antmicro/caravel_board/hardware/caravel_Nucleo/caravel_Nucleo.kicad_pcb

## KiCad design hardware/caravel_Nucleo/caravel_Nucleo.kicad_pcb (2022-12-19)

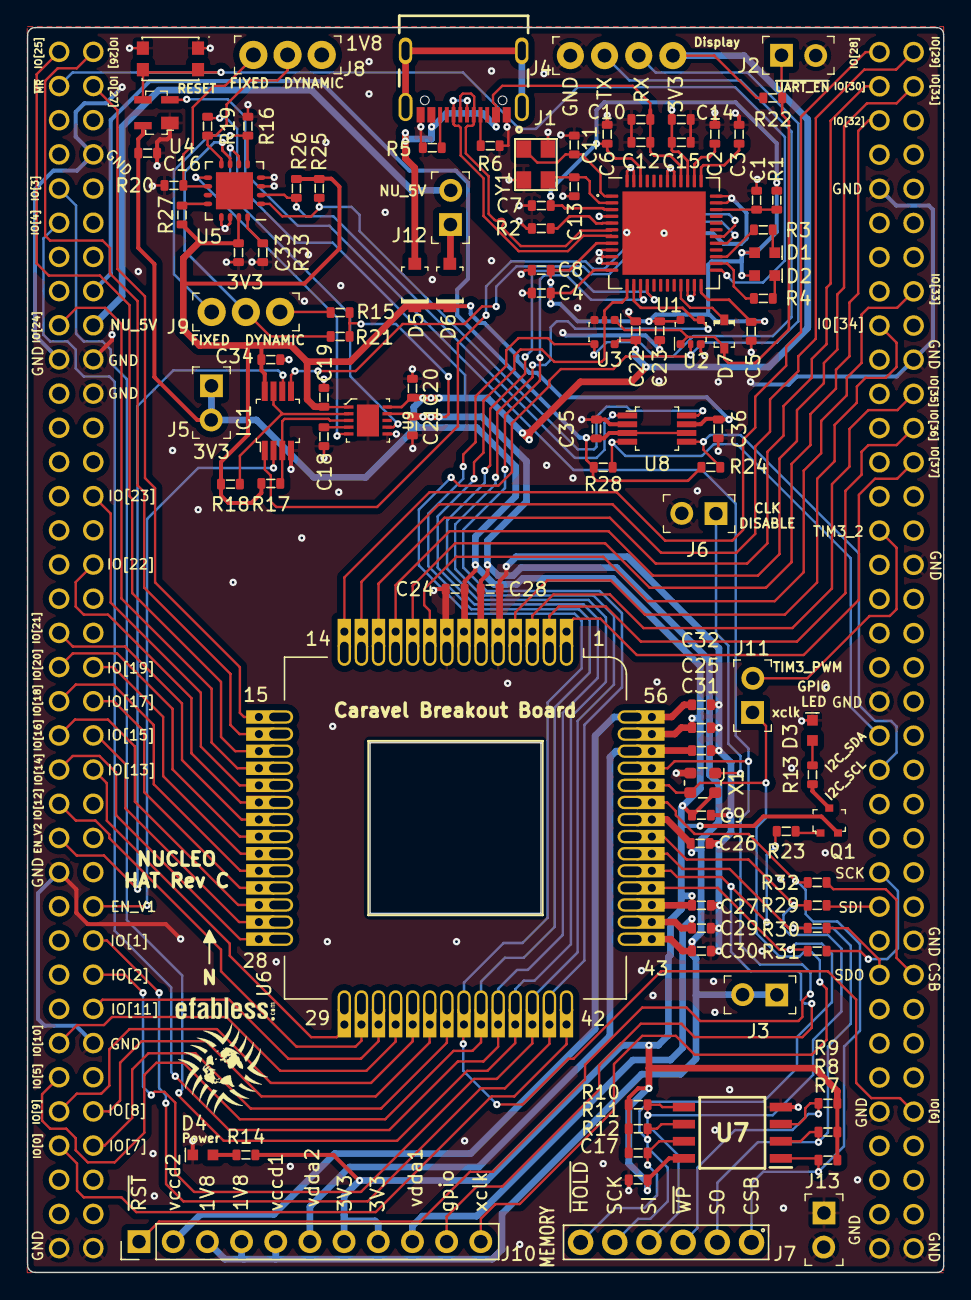
[picture p11: board caravel_Nucleo.kicad_pcb from above]

Board: 4 copper layers, 68.1 x 92.5 mm, 106 parts (0 on the bottom side), 106 nets.

Parts:
C1, C19: C_10n_0603; 0603-cap
C2, C3, C4, C5, C6, C7, C8, C9, C12, C15, C16, C17, C22, C23, C24, C25, C26, C27, C28, C29, C30, C31, C32, C33, C34, C35, C36: C_100n_0603; 0603-cap
C10, C14: C_4u7_0603; 0603-cap
C11, C13: C_18p_0603; 0603-cap
C18, C20, C21: C_1u_0603; 0603-cap
D1, D2, D3, D4: KP-1608ZGC; LED_0603
D5, D6: 1N5819HW-7-F; SOD-123
D7: PMEG6002EJ,115; SOD-323F
IC1: 74LVC2G32DP,125; TSSOP-8_W3mm
J1: USB4105-GF-A; GCT_USB4105-GF-A
J2, J3, J5, J6, J11, J12, J13: PinHeader_1x02; PinHeader_1x2_P2.54mm
J4: 61300411121; PinHeader_1x4_P2.54mm_Drill1.02mm
J7: 61300611121
J8, J9: 640456-3; PinHeader_1x3_P2.54_Drill1.1mm
J10: PinHeader_1x11; PinHeader_1x11_P2.54_Vertical
Q1: BSS84AKW; SOT-323
R1, R7, R8, R9, R10, R11, R12, R17, R18, R21, R22, R23, R27: R_10k_0603; 0603-res
R2: R_12k_0603; 0603-res
R3, R4, R13, R14: R_470R_0603; 0603-res
R5, R6: R_5k1_0603; 0603-res
R15: R_15k_0603; 0603-res
R16: R_34k_0603; 0603-res
R19: R_68k_0603; 0603-res
R20: R_41k2_0603; 0603-res
R24, R25, R26, R28: R_4k7_0603; 0603-res
R29, R30, R31, R32, R33: R_0R_0603; 0603-res
SW1: KMR2; SW_SPST_4.2x2.8
T1: efabless_logo; logo
T2: efabless_logo
U1: FT232HQ; QFN-48-1EP_8x8mm_P0.5mm_EP6.2x6.2mm_FT232HQ_marking
U2, U3: SN74LVC1G125DCKR; SOT-353
U4: MAX811REUS+T; SOT-143-4
U5: MCP4661-103E/ML; QFN-16_EP_4x4_Pitch0.65mm
U6: Caravel_breakout_PCB; caravel_breakout
U7: W25Q32FVSS; SOIC127P790X216-8N
U8: NTS0102DP; TSSOP-8_W3mm
U9: MIC2211-AAYML-TR; DFN-10-1EP_3x3mm
U12: NUCLEO144-F429ZI; ST_Morpho_Connectors_144
X1: ECS-2520MVLC-100-BN-TR; Oscillator_SMD_ECS_2520MV-xxx-xx-4Pin_2.5x2.0mm
Y1: ABM8G-12.000MHZ-18-D2Y-T; KX-7

Connections:
+1V8: C21.1, C26.2, C28.2, C30.2, J3.1, J3.2, J10.3, J10.4, J10.5, R15.2, R21.2, U6.6 (VCCD), U6.43 (VCCD1), U6.50 (VCCD), U9.9 (VOUT2)
+3V3: C9.2, C16.1, C17.1, C20.1, C22.1, C24.2, C25.2, C27.2, J4.4, J5.1, J5.2, J10.7, J10.8, Q1.2 (S), R7.1, R8.1, R9.1, R10.1, R11.1, R12.1, R14.2, R19.2, R22.2, U3.5 (VCC), U4.4 (VCC), U6.7 (VDDIO), U6.45 (VDDA), U6.55 (VDDIO), U7.8 (VCC), U9.10 (VOUT1), X1.4 (VDD)
+5V: C18.1, C33.1, C34.1, C36.1, D5.K, D6.K, IC1.8 (VCC), R17.2, R18.2, R25.2, R26.2, R27.1, U5.15 (VDD), U8.7 (VCC_B), U9.1 (VIN)
/CC1: J1.A5 (CC1), R6.1
/CC2: J1.B5 (CC2), R5.1
/Caravel_CSB: J7.1, R7.2, R32.2, U6.51 (~FLASH_CS), U7.1 (~CS)
/Caravel_D0: J7.4, R10.2, R29.2, U6.49 (FLASH_D0), U7.5 (SI(D0))
/Caravel_D1: J7.2, R8.2, R30.2, U6.48 (FLASH_D1), U7.2 (SO(D1))
/Caravel_SCK: J7.5, R11.2, R31.2, U6.46 (FLASH_SCK), U7.6 (SCK)
/EN_1V8_FTDI: IC1.5 (2A), U1.29 (ACBUS5)
/EN_1V8_STM: IC1.6 (2B), U12.47 (PE3)
/EN_3V3_FTDI: IC1.1 (1A), U1.30 (ACBUS6)
/EN_3V3_STM: IC1.2 (1B), U12.52 (PF2)
/EN_VOUT1: IC1.7 (1Y), R18.1, U9.2 (EN1)
/EN_VOUT2: IC1.3 (2Y), R17.1, U9.3 (EN2)
/FTDI_3V3: C4.1, C5.1, C6.1, C7.1, C8.1, C14.1, C15.2, C23.1, D1.1, D2.1, R1.1, U1.3 (VPHY), U1.8 (VPLL), U1.12 (VCCIO), U1.24 (VCCIO), U1.39 (VCCD), U1.46 (VCCIO), U2.5 (VCC)
/FTDI_DN: J1.A7 (D-), J1.B7 (D-), U1.6 (DM)
/FTDI_DP: J1.A6 (D+), J1.B6 (D+), U1.7 (DP)
/FTDI_RESET: C1.1, R1.2, U1.34 (~RESET)
/I2C4_SCL: R25.1, U5.1 (SCL), U8.8 (B1)
/I2C4_SCL_3V3: R24.1, U8.5 (A1), U12.115 (PD12)
/I2C4_SDA: R26.1, U5.2 (SDA), U8.1 (B2)
/I2C4_SDA_3V3: R28.1, U8.4 (A2), U12.113 (PD13)
/LV_BOOSTER: J9.3, R21.1
/NU_3V3: C35.1, R24.2, R28.2, U8.3 (VCC_A), U8.6 (OE), U12.16 (+3V3)
/NU_5V: J12.2, U12.18 (+5V)
/NU_5V_JMPR: D6.A, J12.1
/P0A: J8.2, R19.1, U5.8 (P0A)
/P0B: J8.1, R20.2, U5.10 (P0B)
/P0W: U5.9 (P0W), U9.5 (ADJ1)
/P1A: J9.2, R15.1, U5.7 (P1A)
/P1B: J9.1, R16.2, U5.5 (P1B)
/P1W: U5.6 (P1W), U9.7 (ADJ2)
/REF: R2.2, U1.5 (REF)
/SPI4_CS: R32.1, U12.128 (PE11)
/SPI4_MISO: R30.1, U12.127 (PE13)
/SPI4_MOSI: R29.1, U12.123 (PE14)
/SPI4_SCK: R31.1, U12.121 (PE12)
/SPI5_CS: U1.16 (ADBUS3), U6.39 (~CS_IO3), U12.9 (PF6)
/SPI5_MISO: U1.15 (ADBUS2), U6.41 (SDO_IO1), U12.54 (PF8)
/SPI5_MOSI: U1.14 (ADBUS1), U2.4 (Y), U6.40 (SDI_IO2), U12.56 (PF9)
/SPI5_SCK: U1.13 (ADBUS0), U3.2 (A), U6.38 (SCK_IO4), U12.11 (PF7)
/TIM3_CH2: J11.2, U12.101 (PB5)
/UART8_RX: J4.3, U2.2 (A), U6.36 (TX_IO6), U12.136 (PE0)
/UART8_TX: J4.2, U3.4 (Y), U6.37 (RX_IO5), U12.61 (PE1)
/VCCA: C3.2, U1.37 (VCCA)
/VCORE: C2.2, U1.38 (VCCCORE)
/XIN: C11.1, U1.1 (XCSI), Y1.1
/XOUT: C13.1, U1.2 (XCSO), Y1.3
/gpio: J10.10, R23.2, U6.47 (GPIO)
/mprj_io[0]: U6.42 (IO0), U12.65 (PG12)
/mprj_io[7]: U6.35 (IO7), U12.66 (PG10)
/mprj_io[8]: U6.34 (IO8), U12.64 (PG15)
/mprj_io[9]: U6.33 (IO9), U12.63 (PG9)
/mprj_io[10]: U6.32 (IO10), U12.59 (PG0)
/mprj_io[11]: U6.31 (IO11), U12.58 (PG1)
/mprj_io[12]: U6.30 (IO12), U12.45 (PD7)
/mprj_io[13]: U6.29 (IO13), U12.44 (PG3)
/mprj_io[14]: U6.28 (IO14), U12.43 (PD6)
/mprj_io[15]: U6.27 (IO15), U12.42 (PG2)
/mprj_io[16]: U6.26 (IO16), U12.41 (PD5)
/mprj_io[17]: U6.25 (IO17), U12.40 (PD3)
/mprj_io[18]: U6.24 (IO18), U12.39 (PD4)
/mprj_io[19]: U6.23 (IO19), U12.38 (PC0)
/mprj_io[20]: U6.22 (IO20), U12.37 (PC3)
/mprj_io[21]: U6.21 (IO21), U12.35 (PC2)
/mprj_io[22]: U6.20 (IO22), U12.32 (PA4)
/mprj_io[23]: U6.19 (IO23), U12.28 (ETH_REF_CLK/PA0)
/mprj_io[24]: U6.18 (IO24), U12.17 (PA15)
/mprj_io[25]: U6.17 (IO25), U12.1 (PC10)
/mprj_io[26]: U6.16 (IO26), U12.2 (PC11)
/mprj_io[27]: U6.15 (IO27), U12.4 (PD2)
/mprj_io[28]: U6.14 (IO28), U12.73 (PC9)
/mprj_io[29]: U6.13 (IO29), U12.74 (PC8)
/mprj_io[30]: U6.12 (IO30), U12.75 (PB8)
/mprj_io[31]: U6.11 (IO31), U12.76 (PC6)
/mprj_io[32]: U6.10 (IO32), U12.77 (PB9)
/mprj_io[33]: U6.9 (IO33), U12.88 (PB12)
/mprj_io[34]: U6.4 (IO34), U12.89 (PB6)
/mprj_io[35]: U6.3 (IO35), U12.94 (PB2)
/mprj_io[36]: U6.2 (IO36), U12.96 (PB1)
/mprj_io[37]: U6.1 (IO37), U12.98 (PB15)
/vccd2: C32.2, J10.2, U6.56 (VCCD2)
/vdda1: C29.2, J10.9, U6.44 (VDDA1)
/vdda2: C31.2, J10.6, U6.54 (VDDA2)
/~MEM_HOLD: J7.6, R12.2, U7.7 (~HOLD(D3))
/~MEM_WP: J7.3, R9.2, U7.3 (~WP(D2))
/~MR: SW1.2, SW1.4, U1.25 (ACBUS1), U4.3 (~MR), U12.3 (PC12)
/~RST: J10.1, U4.2 (~RST), U6.53 (~RST)
/~RX_LED: R4.1, U1.26 (ACBUS2)
/~TX_LED: R3.1, U1.27 (ACBUS3)
/~UART_EN: D7.A, J2.1, R22.1, U2.1 (~OE), U3.1 (~OE)
AGND: C1.2, C2.1, C3.1, C4.2, C5.2, C6.2, C7.2, C8.2, C9.1, C10.2, C11.2, C12.1, C13.2, C14.2, C15.1, C16.2, C17.2, C18.2, C19.1, C20.2, C21.2, C22.2, C23.2, C24.1, C25.1, C26.1, C27.1, C28.1, C29.1, C30.1, C31.1, C32.1, C33.2, C34.2, C35.2, C36.2, D3.2, D4.2, IC1.4 (GND), J1.A1 (GND), J1.A12 (GND), J1.B1 (GND), J1.B12 (GND), J2.2, J4.1, J6.2, J13.1, J13.2, R2.1, R5.2, R6.2, R16.1, R20.1, R33.1, SW1.1, SW1.3, U1.4 (AGND), U1.9 (AGND), U1.10 (GND), U1.11 (GND), U1.22 (GND), U1.23 (GND), U1.35 (GND), U1.36 (GND), U1.41 (AGND), U1.42 (TEST), U1.47 (GND), U1.48 (GND), U1.49 (EP), U2.3 (GND), U3.3 (GND), U4.1 (GND), U5.3 (VSS), U5.4 (VSS), U5.13 (A2), U5.14 (A1), U6.5 (GND), U6.8 (GND), U7.4 (GND), U8.2 (GND), U9.6 (GND), U9.11 (EP), U12.8 (GND), U12.19 (GND), U12.20 (GND), U12.22 (GND), U12.49 (GND), U12.60 (GND), U12.71 (GND), U12.72 (GND), U12.81 (GND), U12.92 (GND), U12.104 (AGND), U12.111 (GND), U12.126 (GND), U12.135 (GND), U12.143 (GND), U12.144 (GND), X1.2 (GND), Y1.2, Y1.4
unnamed: C19.2, U9.4 (BYP)
unnamed: D1.2, R3.2
unnamed: D2.2, R4.2
unnamed: D3.1, R13.1
unnamed: D4.1, R14.1
unnamed: D7.K, U1.21 (ACBUS0)
unnamed: J6.1, X1.1 (EN)
unnamed: Q1.1 (G), R23.1
unnamed: Q1.3 (D), R13.2
unnamed: R27.2, U5.12 (~WP)
unnamed: R33.2, U5.16 (HVC/A0)
VBUS: C10.1, C12.2, D5.A, J1.A4 (VBUS), J1.A9 (VBUS), J1.B4 (VBUS), J1.B9 (VBUS), U1.40 (VREGIN)
xclk: J10.11, J11.1, U6.52 (XCLK), X1.3 (OUT)
