antmicro/caravel_board/(commit log)

2022-12-19 Rework FTDI sheet, begin improving main schematic sheet
    [caravel_Nucleo.kicad_sch, ftdi.kicad_sch]
2022-12-19 Isolate FTDI scheamtic
    [caravel_Nucleo.kicad_sch, ftdi.kicad_sch]
2022-12-19 Simplfy power supply
    [caravel_Nucleo.kicad_sch]
2022-12-19 Replace components to Antmicro library ones
    [ftdi.kicad_sch]
2022-12-19 Adjust divider, add 1V8 LV option
    [caravel_Nucleo.kicad_sch]
2022-12-19 Substituted all components from main schematic sheet except Nucleo connector
    [caravel_Nucleo.kicad_sch]
2022-12-19 Tidy up schematic connections
    [caravel_Nucleo.kicad_sch, ftdi.kicad_sch]
2022-12-19 Finished changing symbols to antmicro global library
    [caravel_Nucleo.kicad_sch, ftdi.kicad_sch]
2022-12-19 Annotate parts on schematic
    [caravel_Nucleo.kicad_sch]
2022-12-19 Update PCB components
    [caravel_Nucleo.kicad_pcb]
2022-12-19 Move components to local library
    [caravel_Nucleo.kicad_pcb, caravel_Nucleo.kicad_sch, ftdi.kicad_sch]
2022-12-19 Update FTDI footprint on PCB
    [caravel_Nucleo.kicad_pcb]
2022-12-19 Initial PCB placement, start routing
    [caravel_Nucleo.kicad_pcb]
2022-12-19 Route FTDI and corresponding interfaces, route dynamic power supply, connect remainig signals
    [caravel_Nucleo.kicad_pcb]
2022-12-19 Finish routing PCB, add I2C logic level translator, fix layer stackup, clear DRC, tidy up silkscreen
    [caravel_Nucleo.kicad_pcb]
2022-12-19 Update STM Morpho 3D model
    [caravel_Nucleo.kicad_pcb]
2022-12-19 Optimize GND via placment
    [caravel_Nucleo.kicad_pcb]
2022-12-19 Update PCB with new components
    [caravel_Nucleo.kicad_pcb]
2022-12-19 Update Efabless logo on PCB
    [caravel_Nucleo.kicad_pcb]
