antmicro/caravel_board/(notices)

Notices in the files:
parts and their libraries:
License: MIT
